ljktofly/IR2184-/封装库/说明.docx

470uF可选两种封装 请按库存状况选择合适的封装

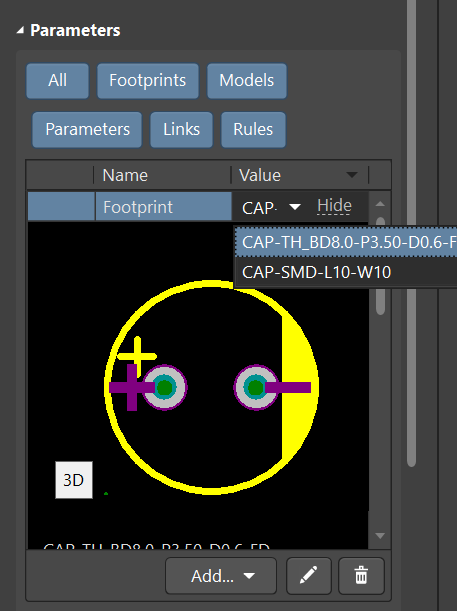
[picture p7: figure]
