ljktofly/IR2184-/IR2184单路驱动原理图.pdf

# 电源端子

5V

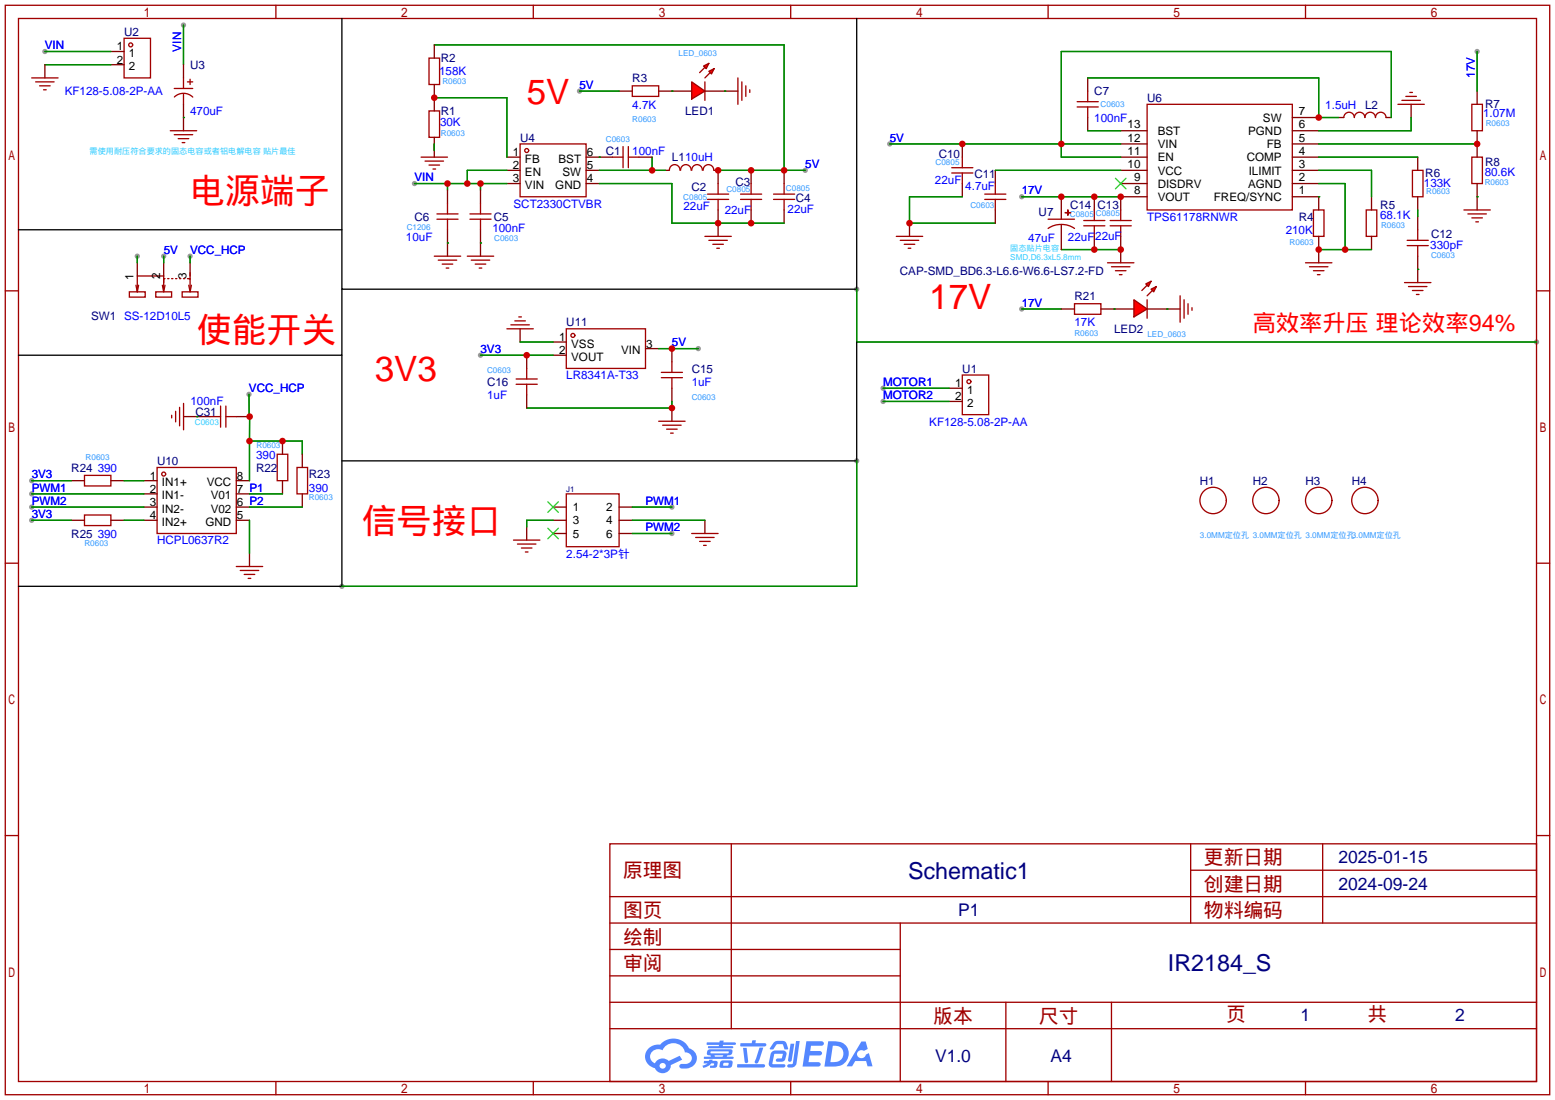
[picture p8: page 1]

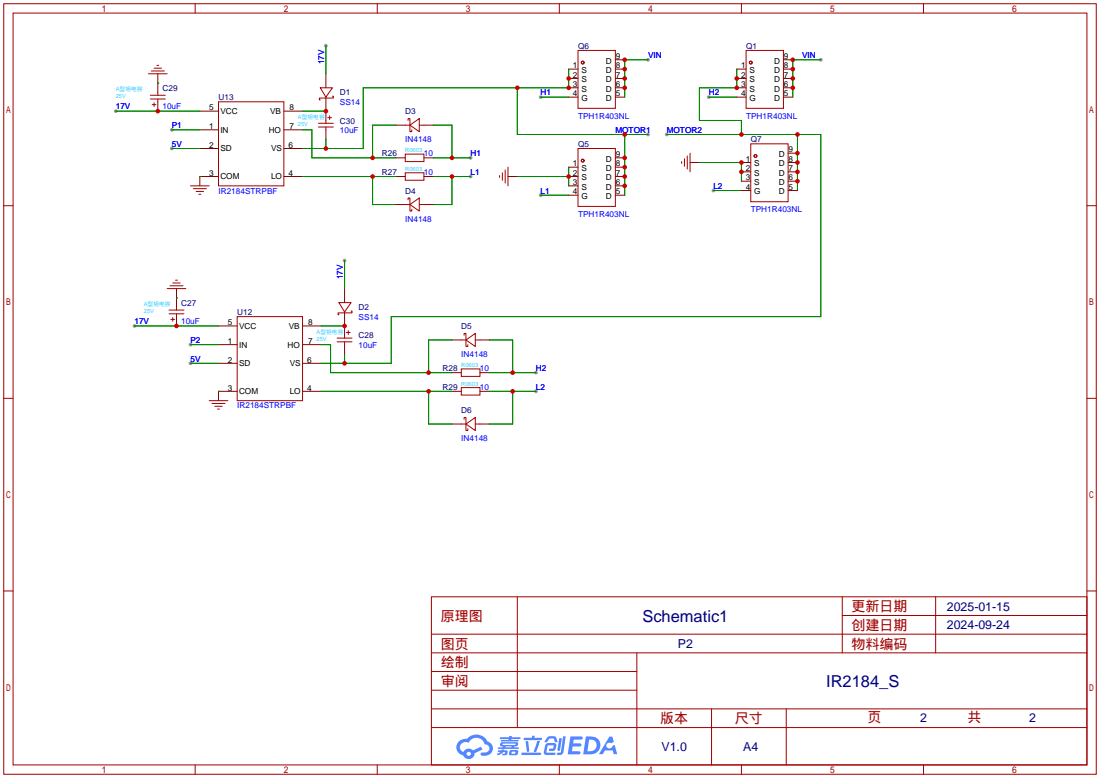
[picture p9: page 2]
