ljktofly/IR2184-/IR2184双驱原理图.pdf

# 电源端子

5V

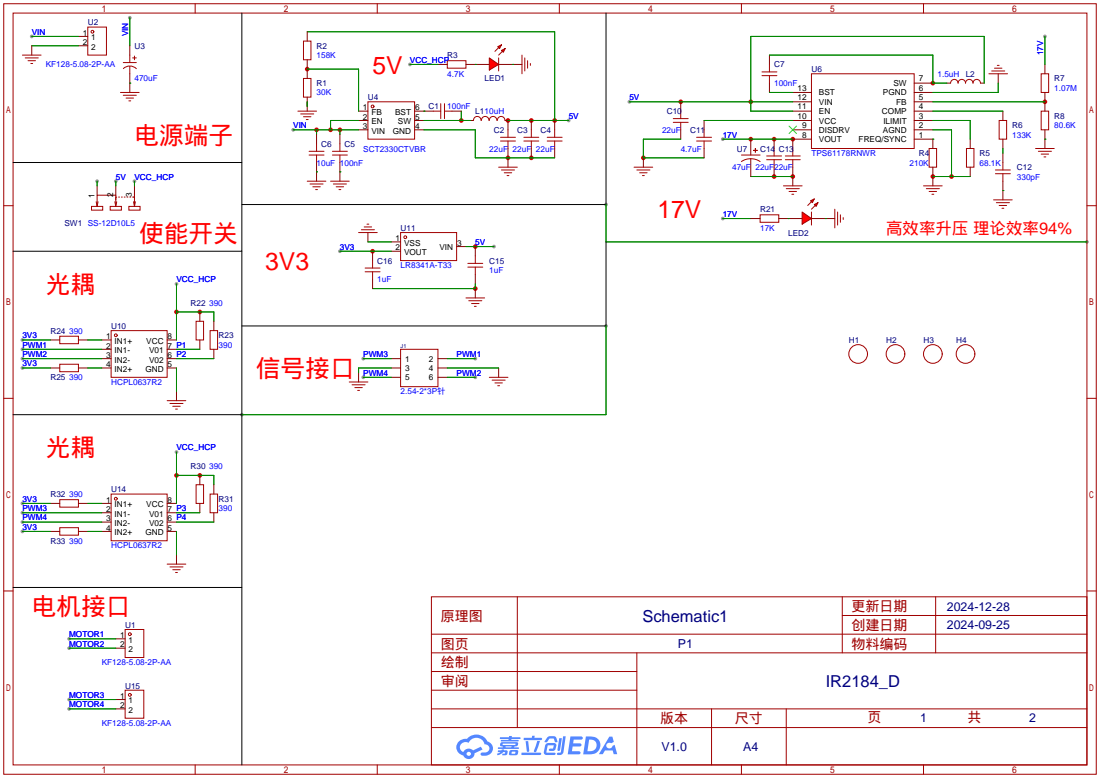
[picture p12: page 1]

# TPH1R403NL D 9 D 8 D 7 D 6 D 5 G

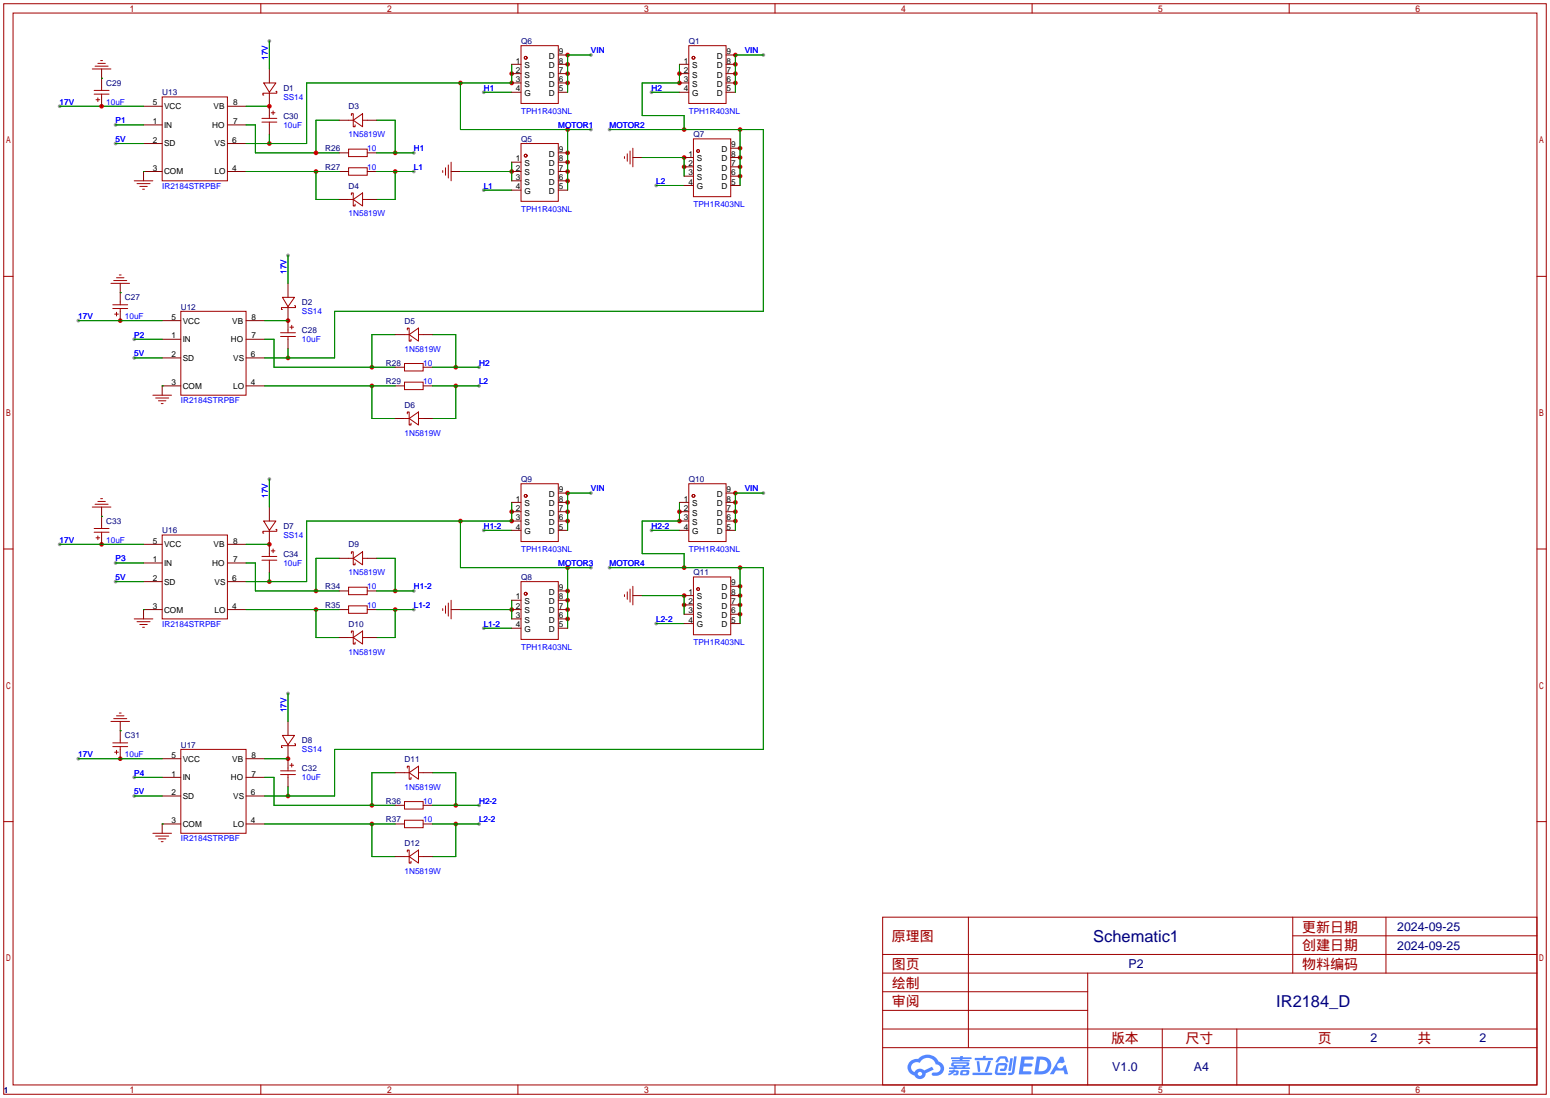
[picture p13: page 2]
