ljktofly/IR2184-/IR2184单驱原理图.pdf

# 电源端子

5V

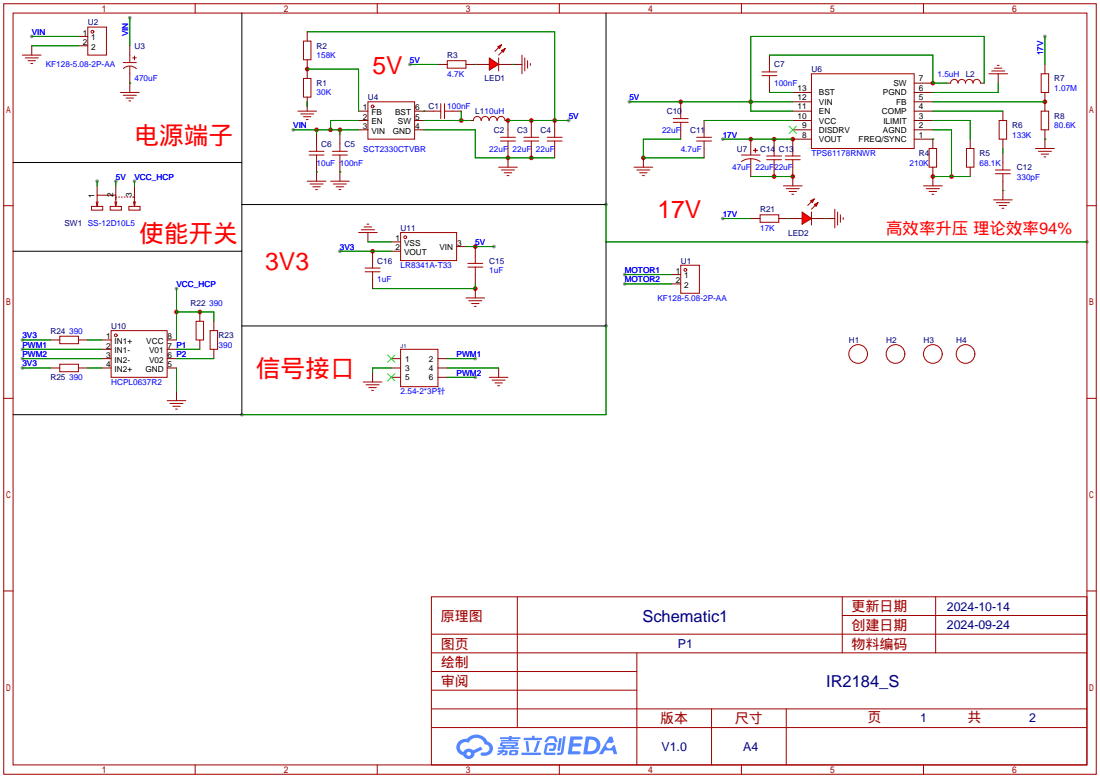
[picture p14: page 1]

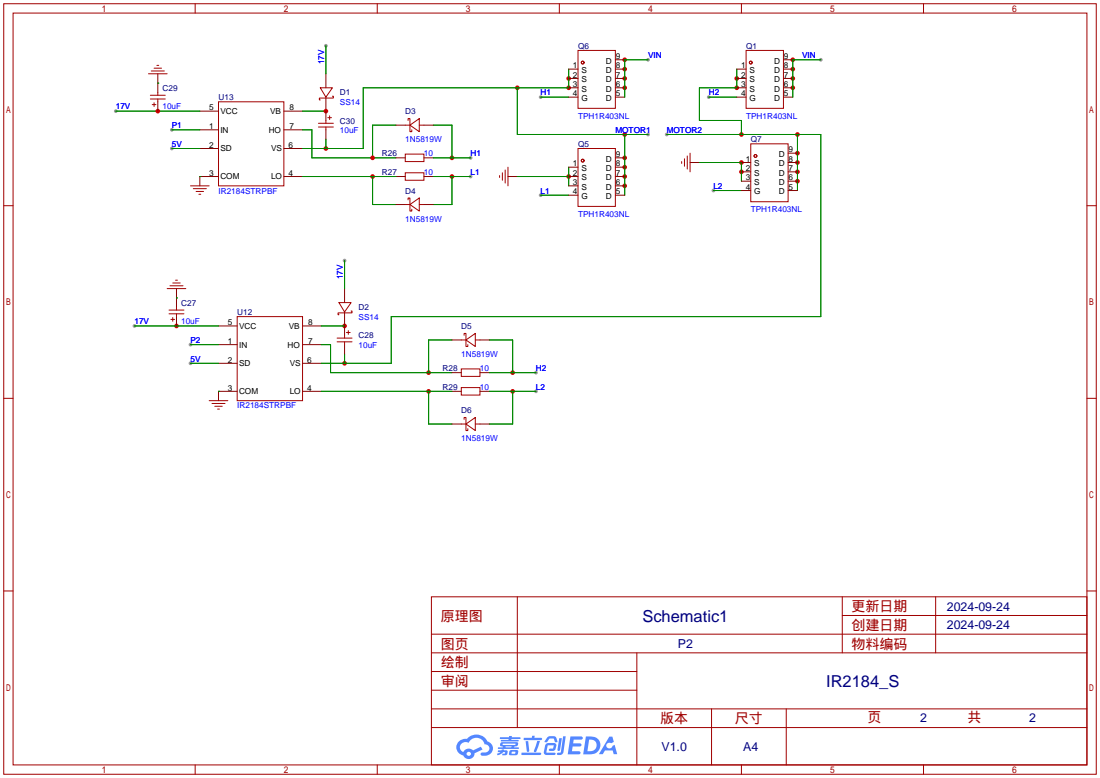
[picture p15: page 2]
