ljktofly/IR2184-/相关文档/IR2184_单驱原理图.pdf

# 电源端子

5V

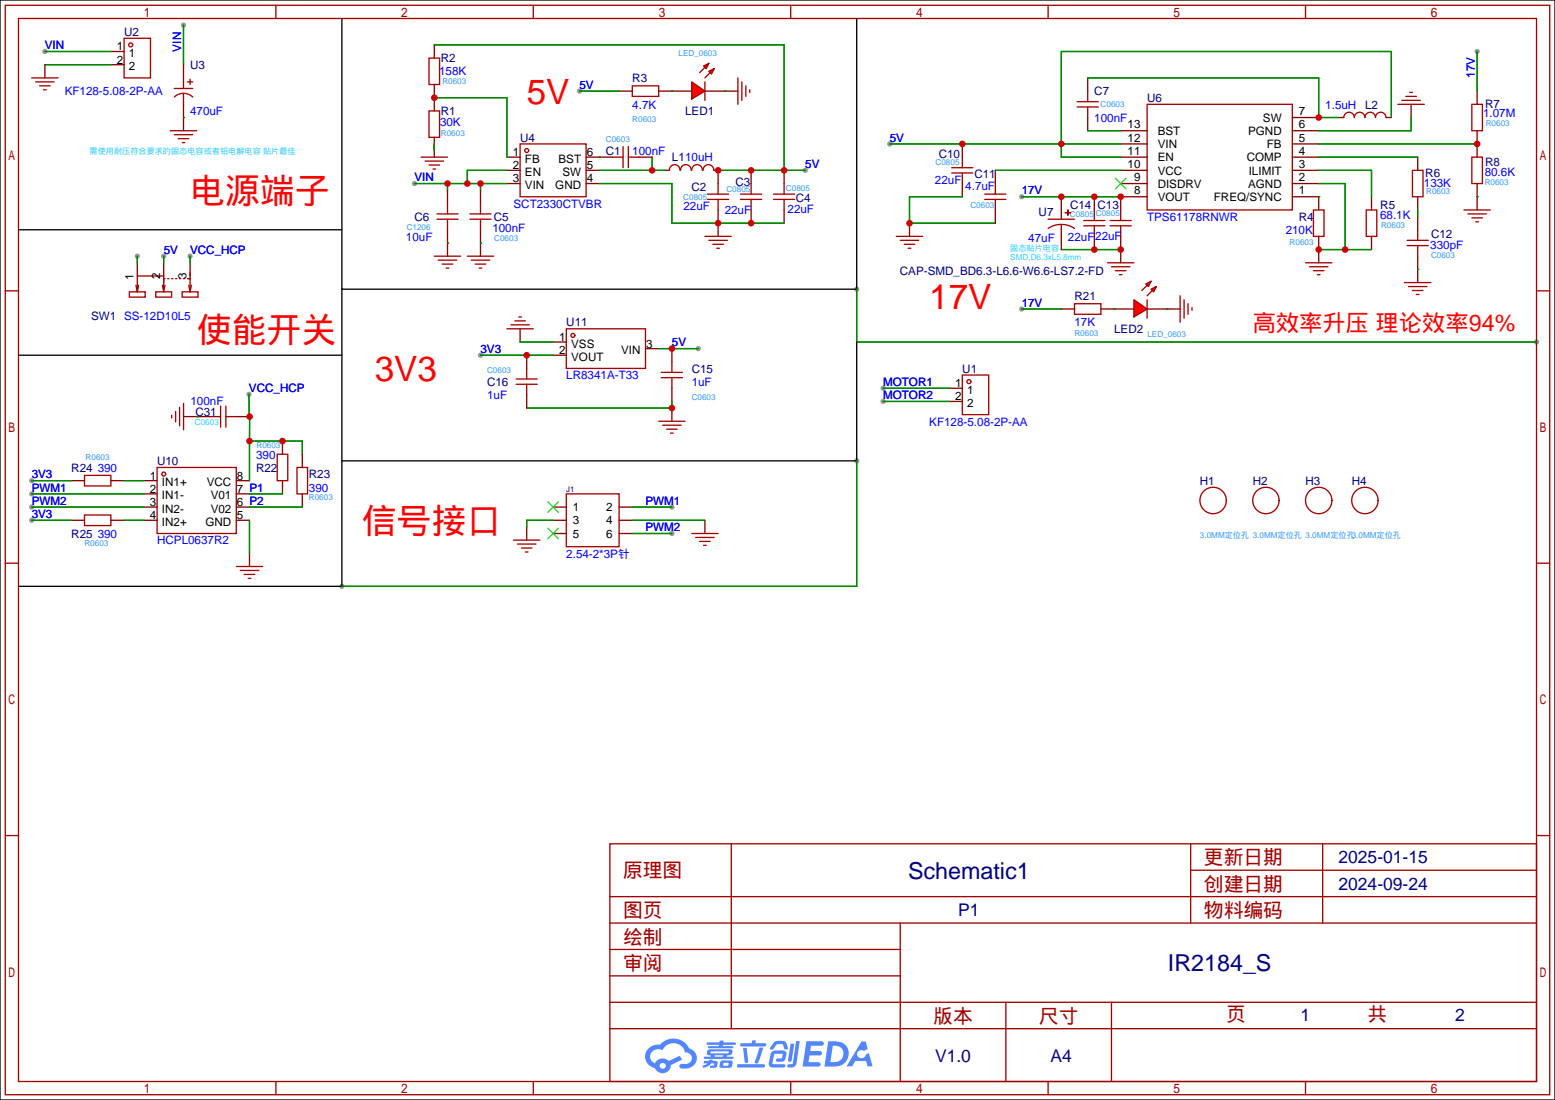
[picture p16: page 1]

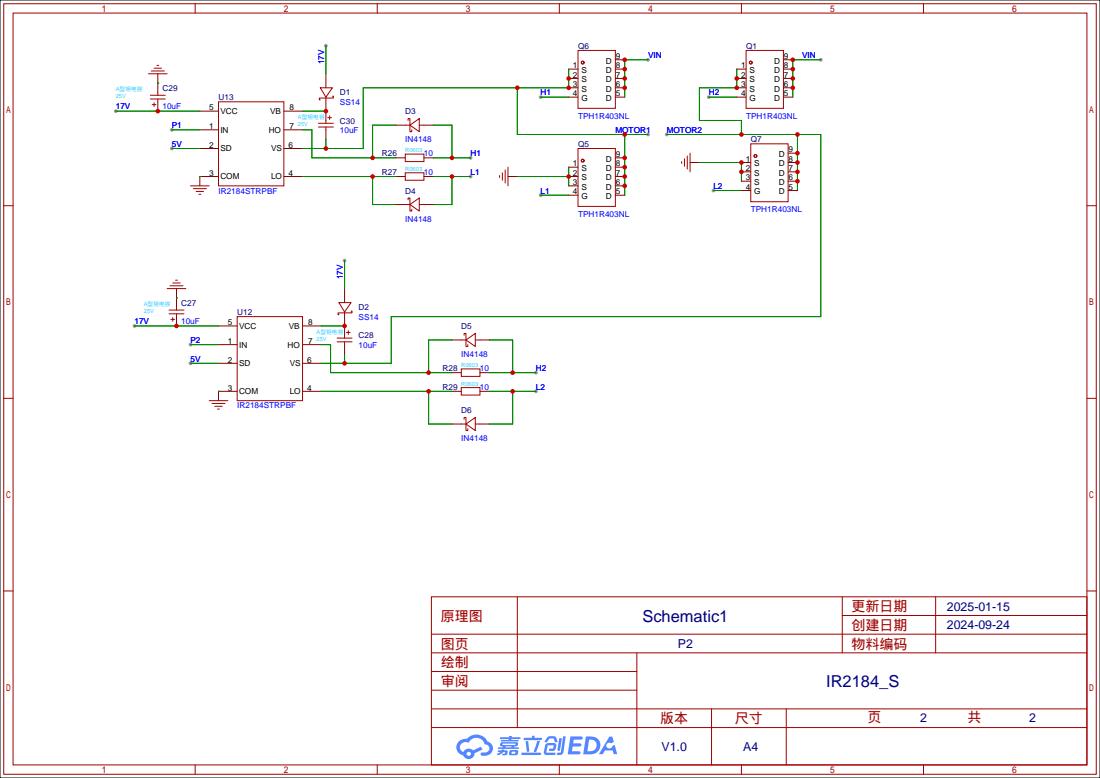
[picture p17: page 2]
