ljktofly/IR2184-/相关文档/IR2184_单驱尺寸图.pdf

# 17V R2¹

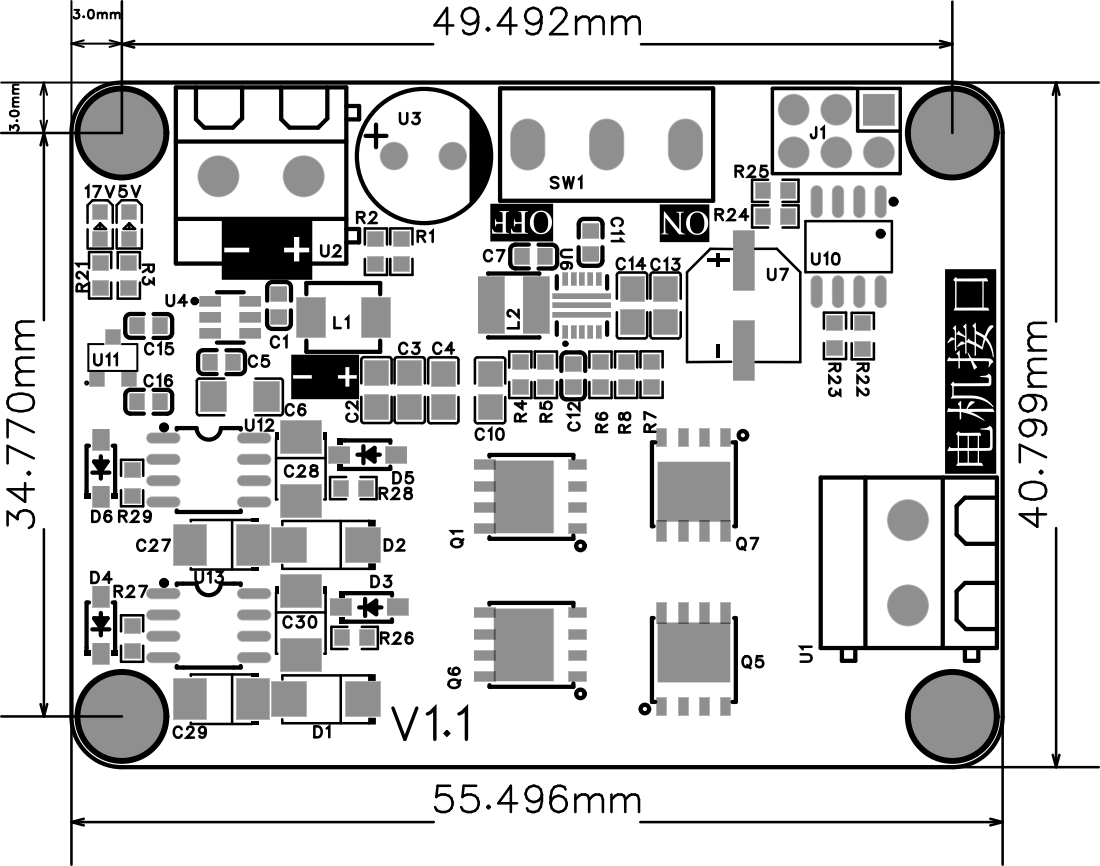
[picture p18: page 1]
