ljktofly/IR2184-/相关文档/IR2184_双驱原理图.pdf

# 电源端子

5V

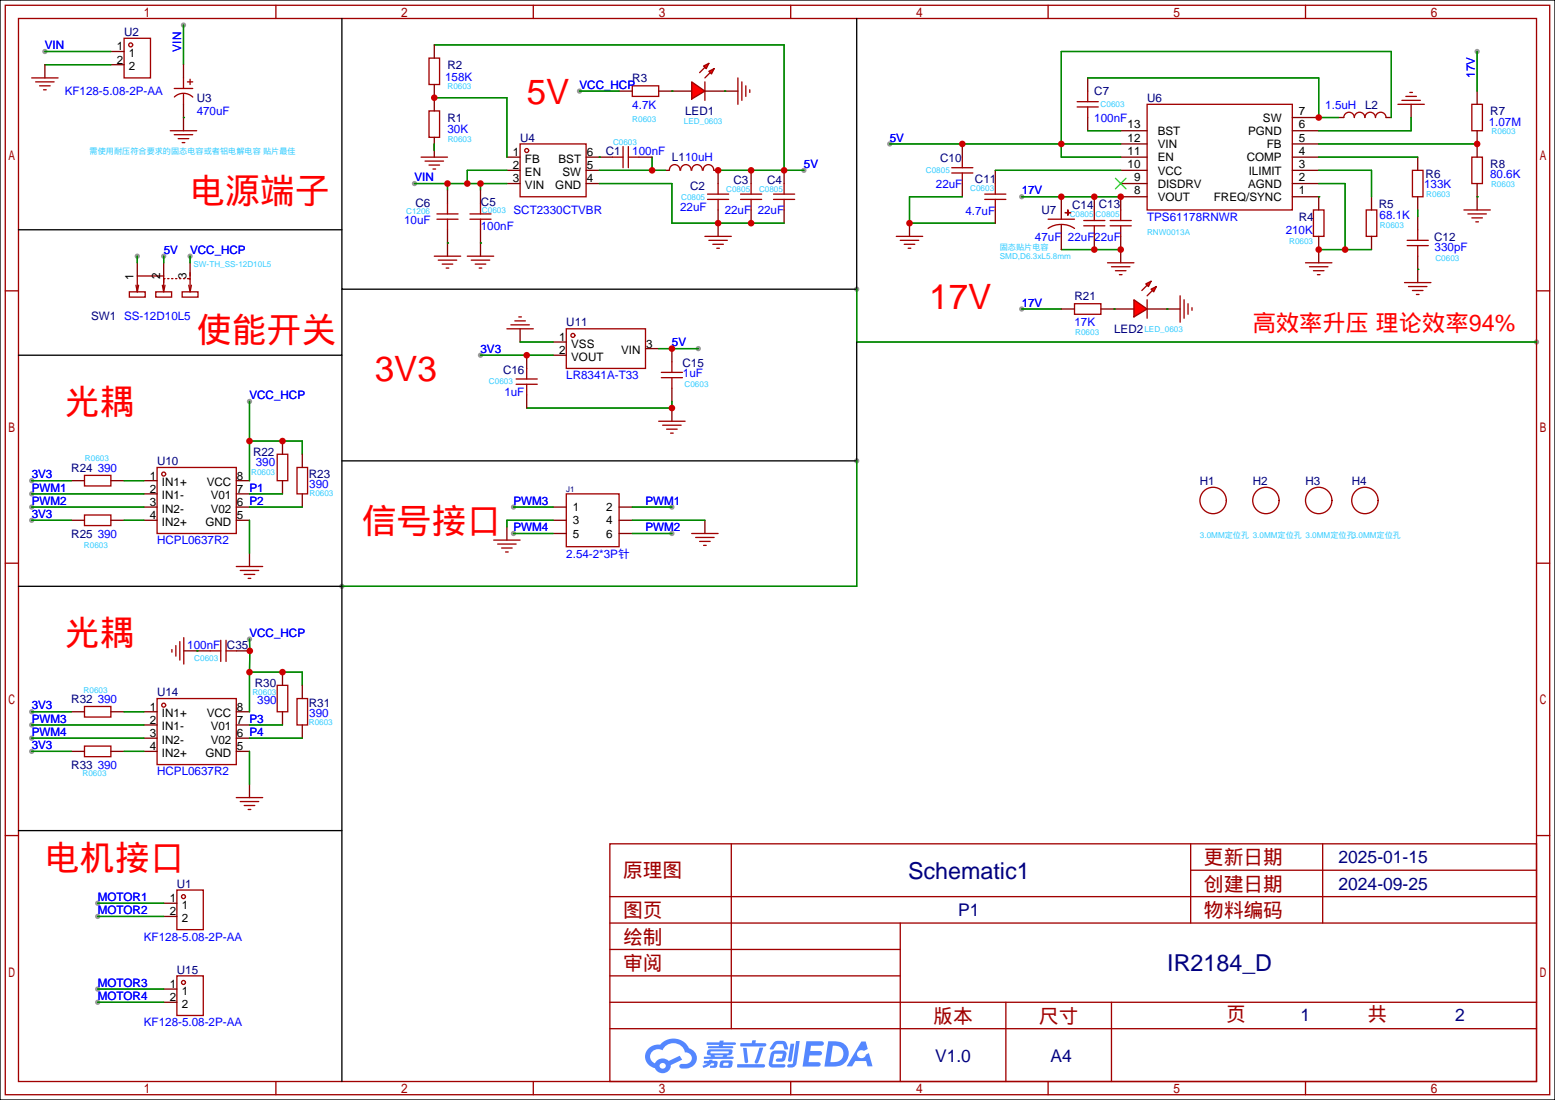
[picture p19: page 1]

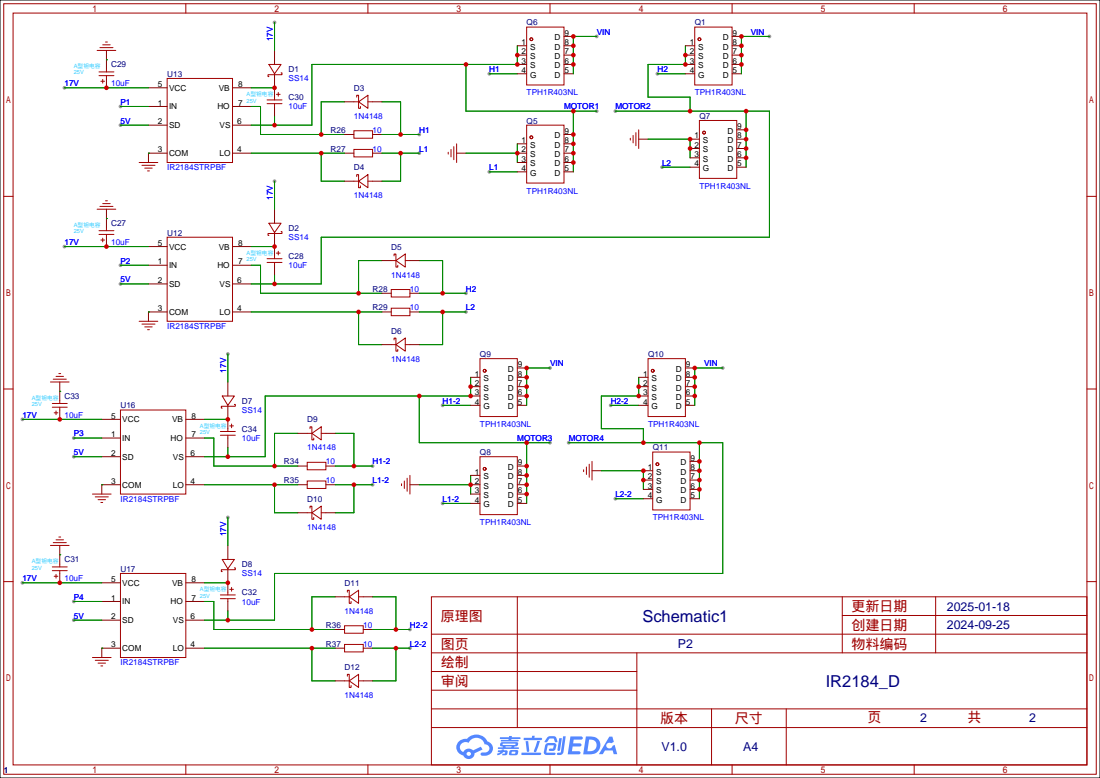
[picture p20: page 2]
