ljktofly/IR2184-/相关文档/IR2184_单驱丝印图.pdf

- +
C7

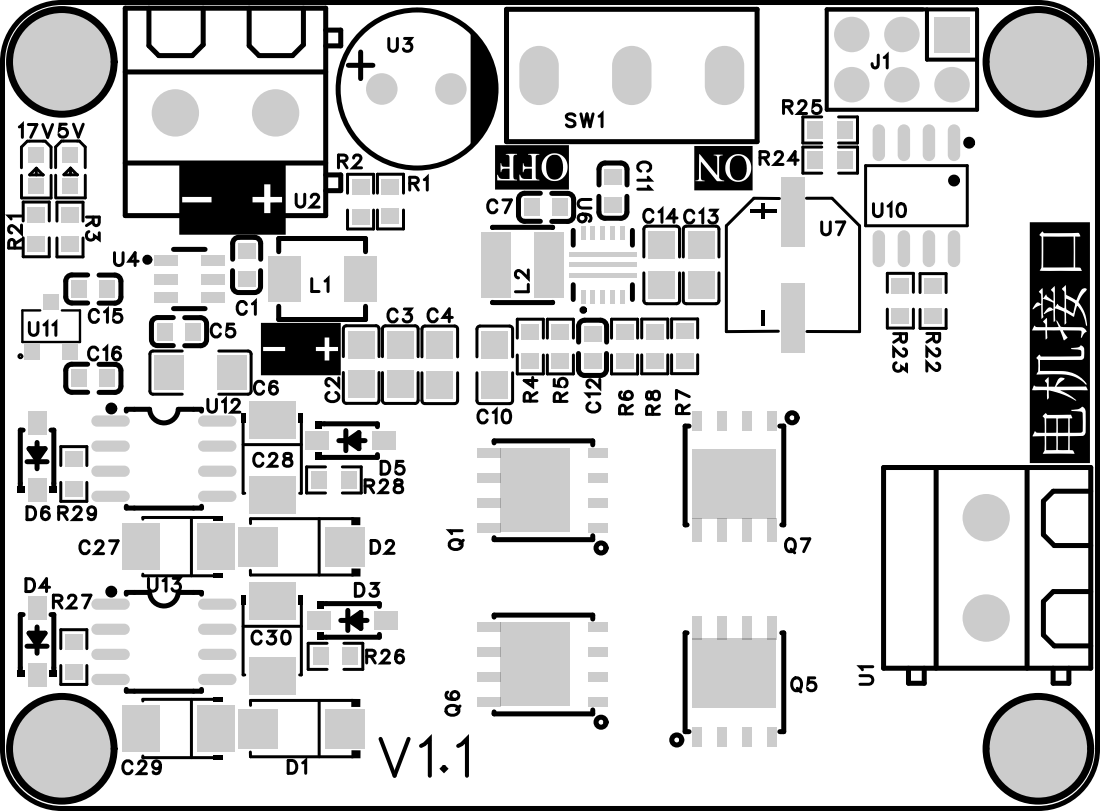
[picture p21: page 1]

- +

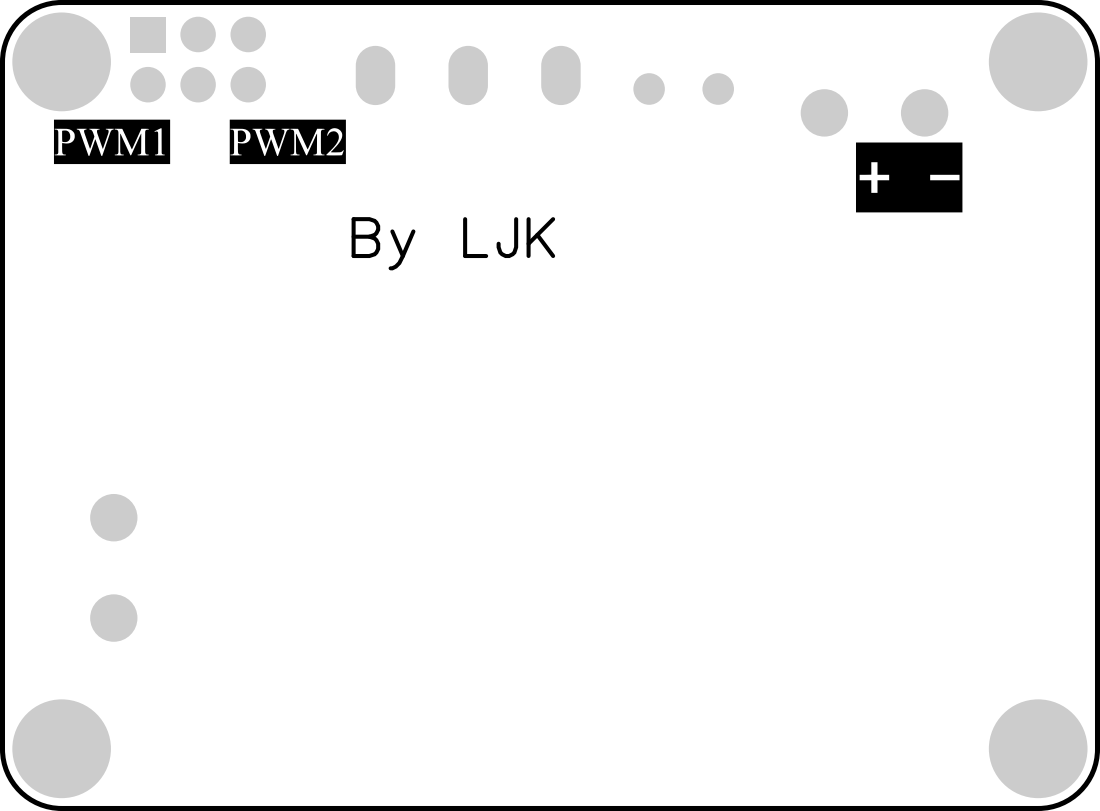
[picture p22: page 2]
