ljktofly/IR2184-/相关文档/IR2184_单驱位号图.pdf

- +

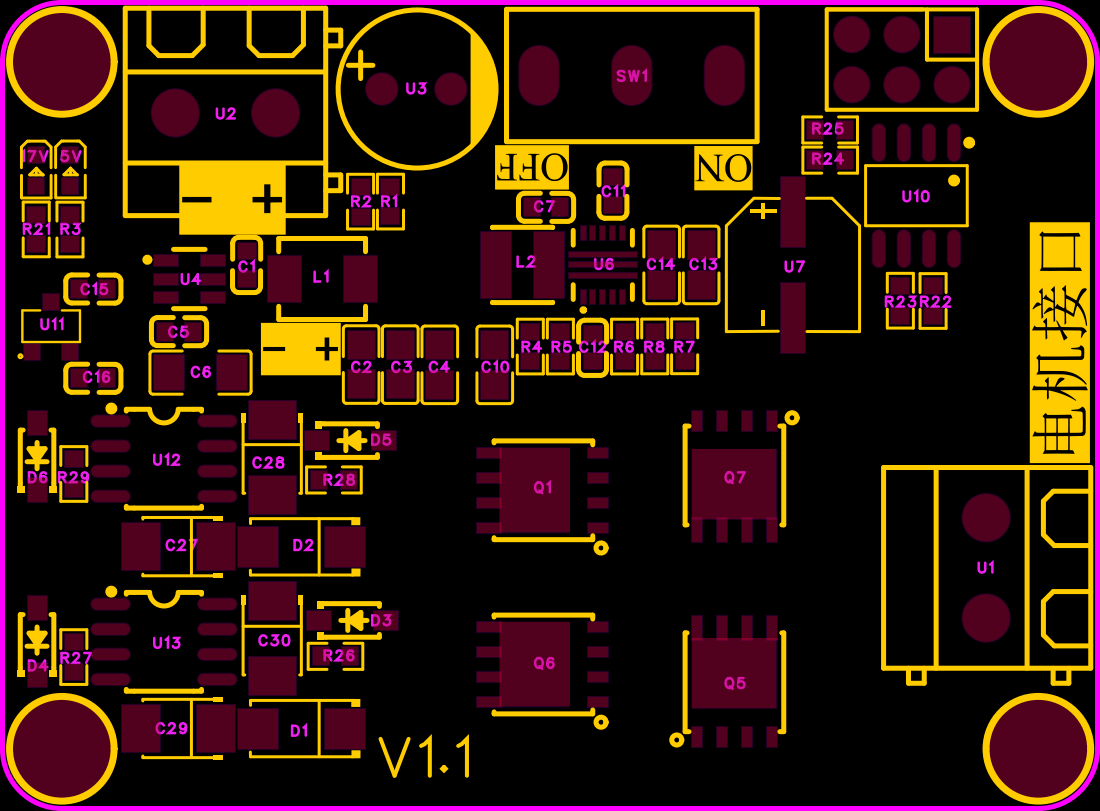
[picture p23: page 1]
