ljktofly/IR2184-/相关文档/IR2184_双驱丝印图.pdf

# ON OFF

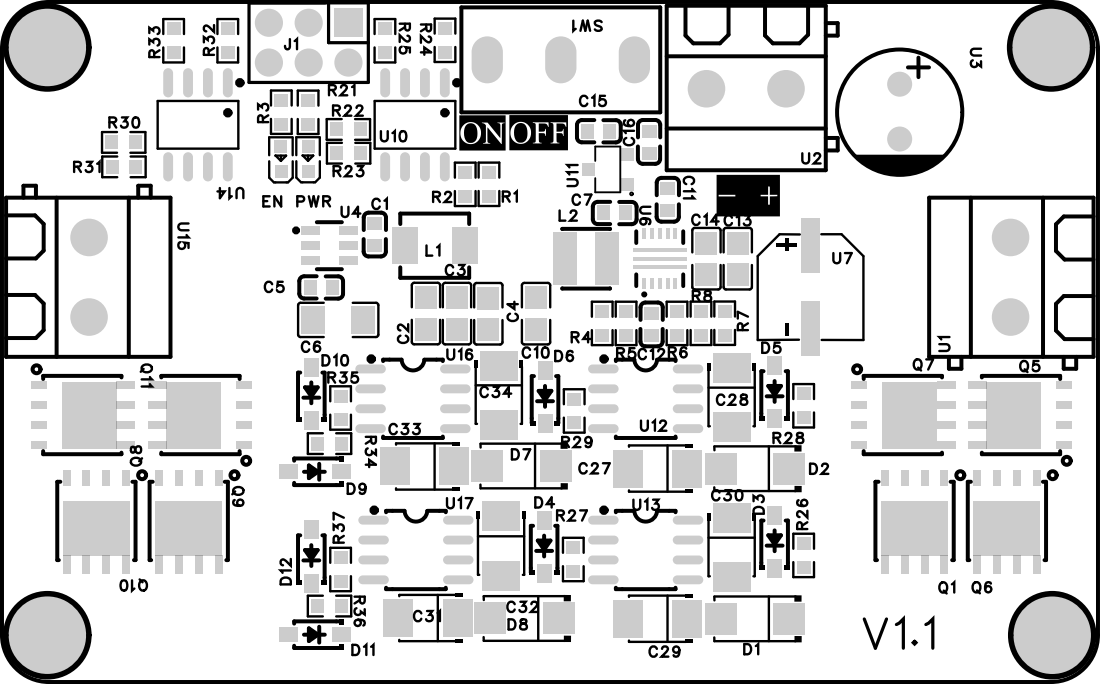
[picture p24: page 1]

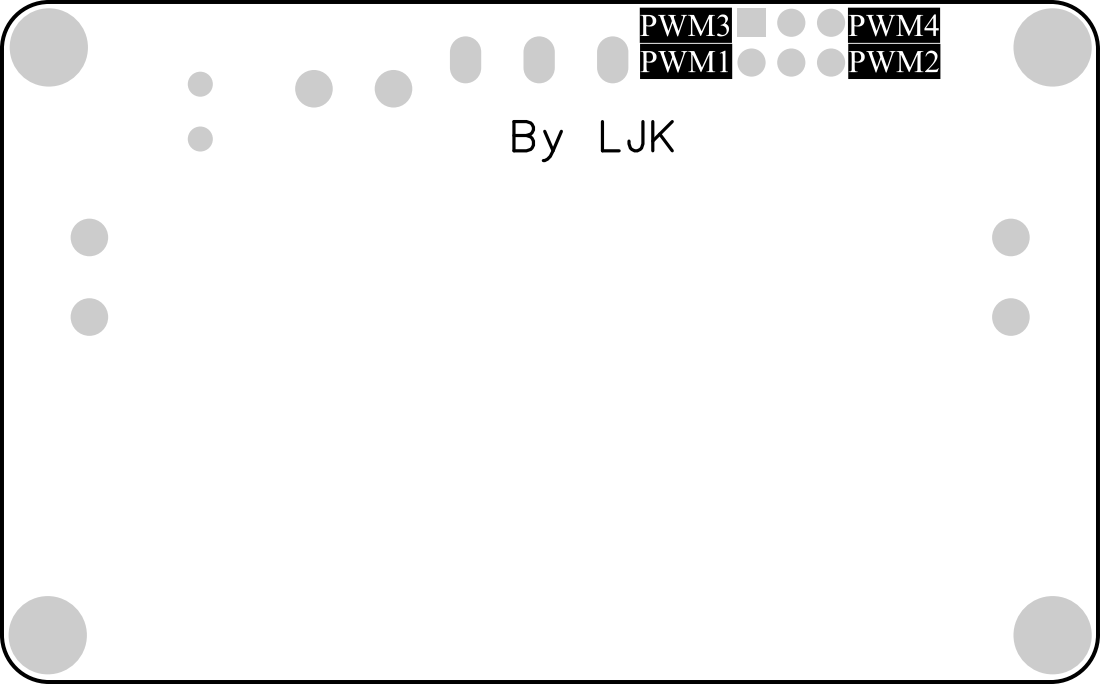
[picture p25: page 2]
