ljktofly/IR2184-/相关文档/IR2184_双驱位号图.pdf

# ON OFF

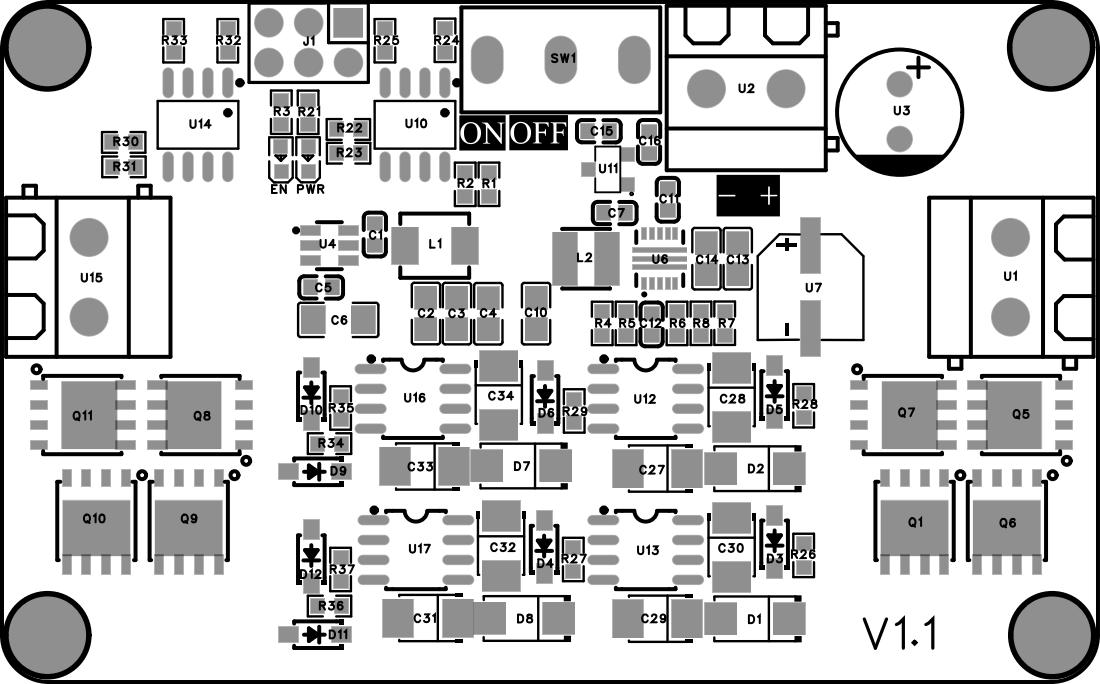
[picture p26: page 1]
