ljktofly/IR2184-/相关文档/IR2184_双驱尺寸图.pdf

# ON OFF

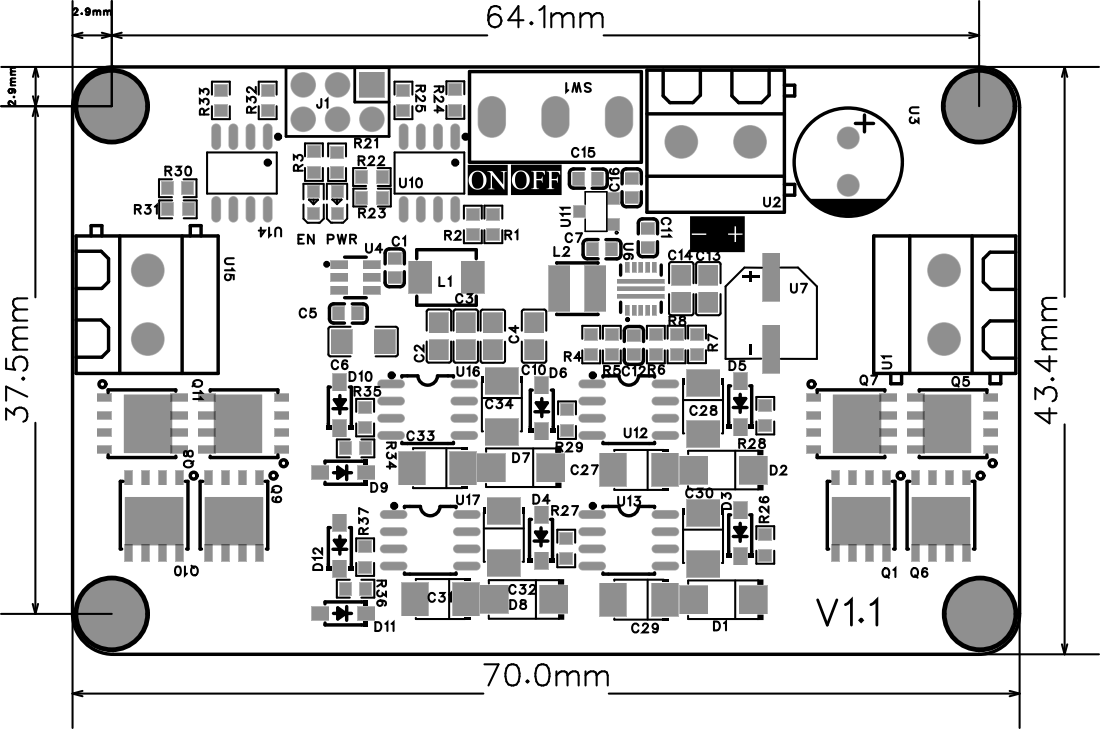
[picture p27: page 1]
