ljktofly/IR2184-/(list of files, drawings)

Other design files:
封装库/IR2184.PcbLib
封装库/IR2184.SCHLIB
