ljktofly/IR2184-/(commit log)

2025-01-15 更新原理图标识
2025-01-24 更新说明文档与例程
2025-01-24 添加了封装库
    [IR2184.PcbLib, IR2184.SCHLIB]
